bobm123/The-Open-Book/Open Book Abridged/OSO-BOOK-C2-02.brd

## EAGLE design Open Book Abridged/OSO-BOOK-C2-02.brd (2022-04-10)

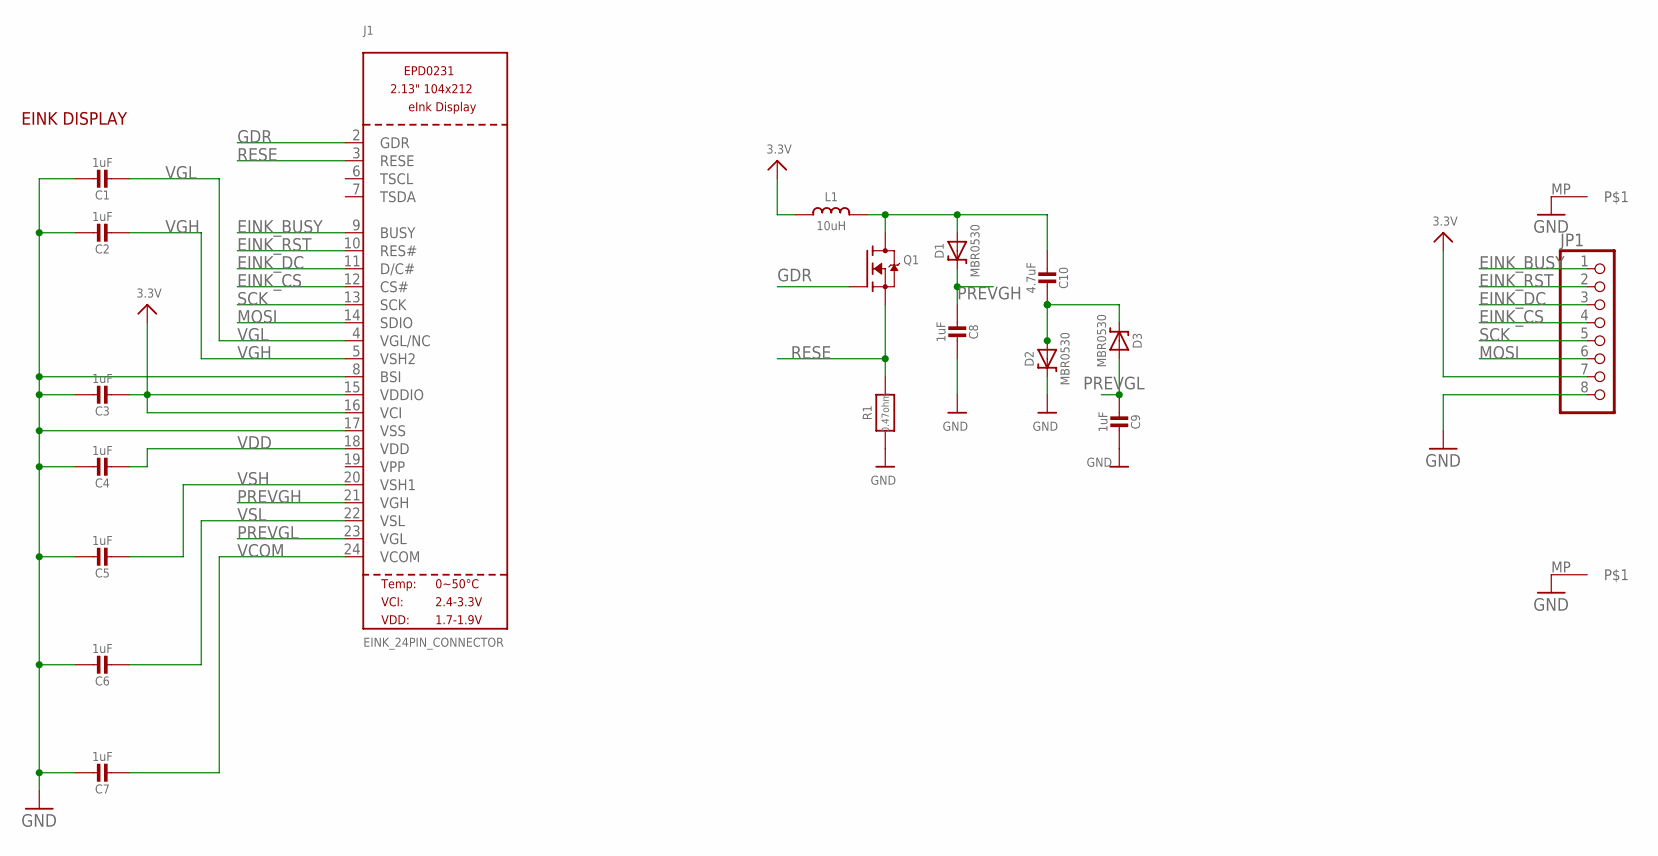
[picture p1: schematic OSO-BOOK-C2-02.sch]

Parts:
C1, C2, C3, C4, C5, C6, C7, C8, C9: 1uF; 0805-NO
C10: 4.7uF; 0805-NO
D1, D2, D3: MBR0530; SOD-123
J1: EINK_24PIN_CONNECTOR; EINK_24PIN
JP1: HEADER-1X8ROUND76; 1X08_ROUND_76
L1: 10uH; MICROBUILDER__0805
Q1: IRLML0100; SOT23-3
R1: 0.47ohm; _0402
U$2, U$3: BIGOVAL

Connections:
3.3V: C3.2, J1.15 (VDDIO), J1.16 (VCI), JP1.7, L1.1
EINK_BUSY: J1.9 (BUSY), JP1.1
EINK_CS: J1.12 (CS#), JP1.4
EINK_DC: J1.11 (D/C#), JP1.3
EINK_RST: J1.10 (RES#), JP1.2
GDR: J1.2 (GDR), Q1.1 (G)
GND: C1.1, C2.1, C3.1, C4.1, C5.1, C6.1, C7.1, C8.2, C9.2, D2.C, J1.8 (BSI), J1.17 (VSS), JP1.8, R1.2, U$2.MP, U$3.MP
MOSI: J1.14 (SDIO), JP1.6
unnamed: C10.2, D2.A, D3.C
unnamed: C10.1, D1.A, L1.2, Q1.3 (D)
PREVGH: C8.1, D1.C, J1.21 (VGH)
PREVGL: C9.1, D3.A, J1.23 (VGL)
RESE: J1.3 (RESE), Q1.2 (S), R1.1
SCK: J1.13 (SCK), JP1.5
VCOM: C7.2, J1.24 (VCOM)
VDD: C4.2, J1.18 (VDD)
VGH: C2.2, J1.5 (VSH2)
VGL: C1.2, J1.4 (VGL/NC)
VSH: C5.2, J1.20 (VSH1)
VSL: C6.2, J1.22 (VSL)

Notes on the sheet:
EINK DISPLAY

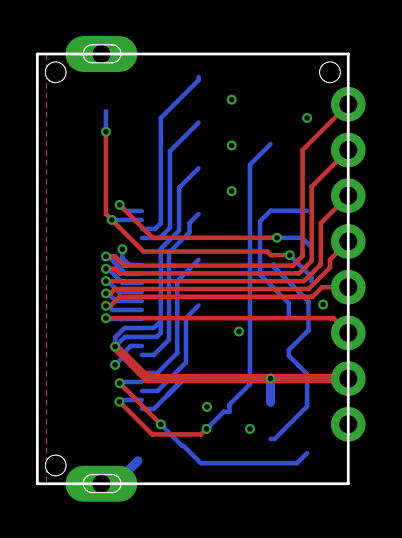
[picture p2: board OSO-BOOK-C2-02.brd from above]

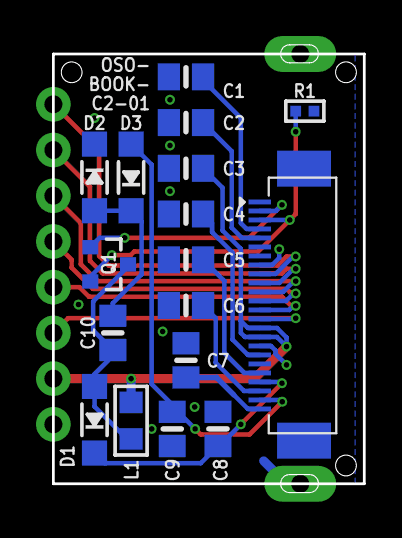
[picture p3: board OSO-BOOK-C2-02.brd from below]

Board: 2 copper layers, 17.3 x 24.9 mm, 20 parts (17 on the bottom side), 20 nets.
