bobm123/The-Open-Book/Open Book Abridged/OSO-BOOK-C3-00.brd

## EAGLE design Open Book Abridged/OSO-BOOK-C3-00.brd (2022-04-10)

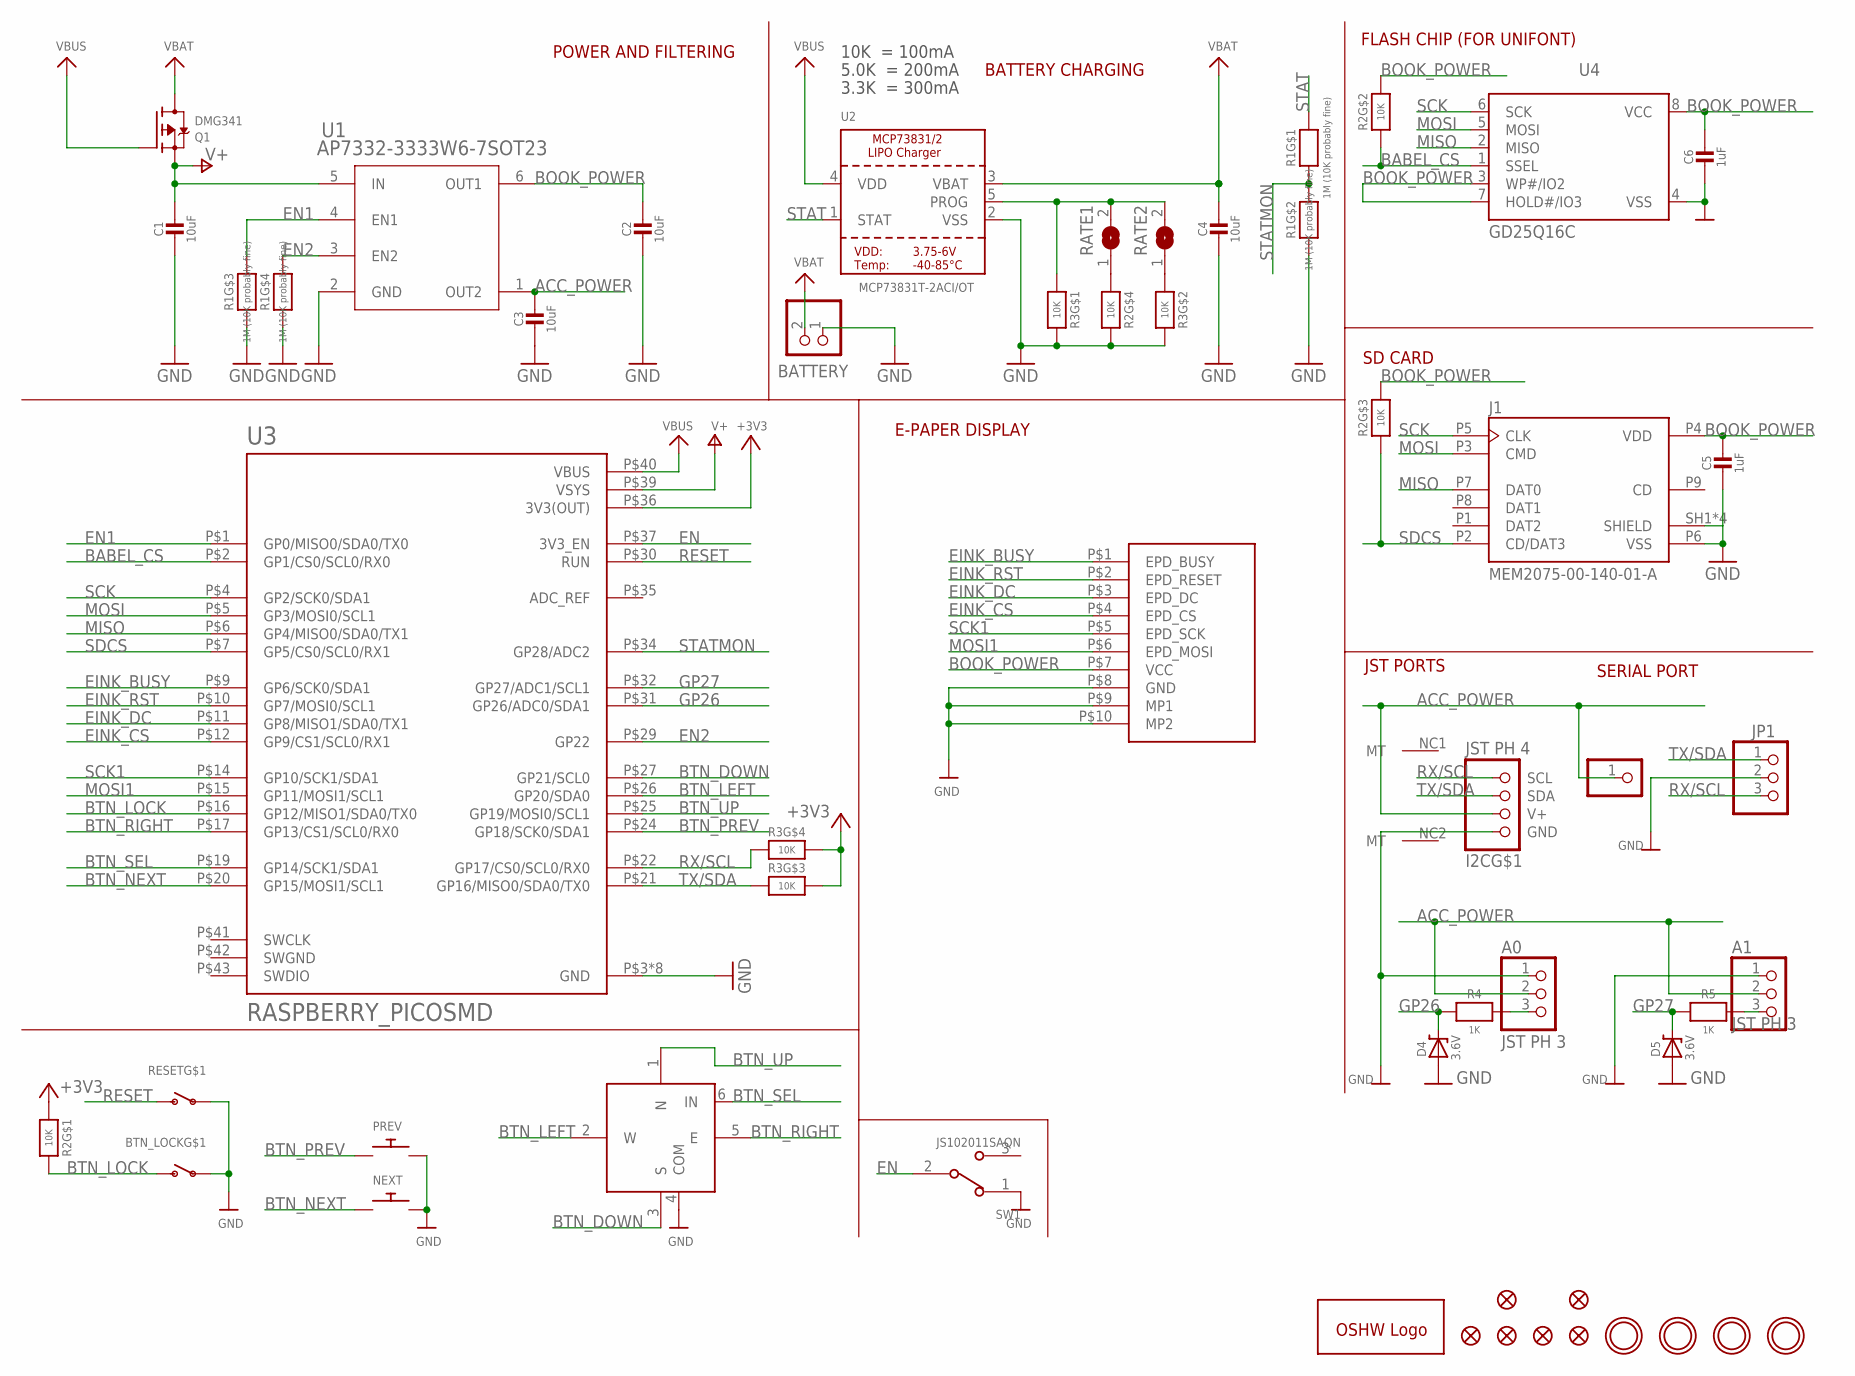
[picture p4: schematic OSO-BOOK-C3-00.sch, sheet 1]

Parts:
A0, A1: JST PH 3; JSTPH3
BATTERY: JSTPH; JSTPH2
BTN_LOCK: SWITCH_SPSTTL3330A; TL3330A
C1, C2, C3, C4: 10uF; 0805-NO
C5, C6: 1uF; 0805-NO
D4, D5: 3.6V; SOD-123
FID1, FID2, FID3, FID4, FID5, FID6: FIDUCIAL_1MM
GOLD_ORB_SM1: OSHWLOGOLOGO5MM; OSHW_5MM
I2C: JST PH 4; JSTPH4
J1: MEM2075-00-140-01-A; GCT_MEM2075-00-140-01-A
JP1: PINHD-1X3; 1X03
JP2: PINHD-1X1; 1X01
NEXT: SWITCH_PUSHBUTTON_3.5X6MM; TACTILE_3X6MM
PREV: SWITCH_PUSHBUTTON_3.5X6MM; TACTILE_3X6MM
Q1: DMG341; SOT23-R
R1: 1M (10K probably fine); EXBV8V
R2, R3: 10K; EXBV8V
R4, R5: 1K; 0805-NO
RATE1, RATE2: SOLDERJUMPER; SOLDERJUMPER_ARROW_NOPASTE
RESET: SWITCH_SPSTTL3330A; TL3330A
SW1: JS102011SAQN; SW_JS102011SAQN
SW2: NAVSWITCHSKQUABAUE010; SKQUBAE010
U1: AP7332-3333W6-7SOT23; SOT23-6
U2: MCP73831T-2ACI/OT; SOT23-5
U3: RASPBERRY_PICOSMD; PICO-PKG-SMD
U4: GD25Q16C; MICROBUILDER_SOIC8_150MIL
U$1, U$4, U$5, U$7: MOUNTINGHOLE2.5; MOUNTINGHOLE_2.5_PLATED
U$11: OSO-BOOK-C2-01

Connections:
+3V3: R2.1, R3.5 (2), R3.6 (2), U3.P$36 (3V3(OUT))
ACC_POWER: A0.2, A1.2, C3.1, I2C.2 (V+), JP2.1, U1.1 (OUT2)
BABEL_CS: R2.2 (1), U3.P$2 (GP1/CS0/SCL0/RX0), U4.1 (SSEL)
BOOK_POWER: C2.1, C5.1, C6.1, J1.P4 (VDD), R2.6 (2), R2.7 (2), U1.6 (OUT1), U4.3 (WP#/IO2), U4.7 (HOLD#/IO3), U4.8 (VCC), U$11.P$7 (VCC)
BTN_DOWN: SW2.3 (S), U3.P$27 (GP21/SCL0)
BTN_LEFT: SW2.2 (W), U3.P$26 (GP20/SDA0)
BTN_LOCK: BTN_LOCK.P$2 (S), R2.8 (2), U3.P$16 (GP12/MISO1/SDA0/TX0)
BTN_NEXT: NEXT.P$1, U3.P$20 (GP15/MOSI1/SCL1)
BTN_PREV: PREV.P$1, U3.P$24 (GP18/SCK0/SDA1)
BTN_RIGHT: SW2.5 (E), U3.P$17 (GP13/CS1/SCL0/RX0)
BTN_SEL: SW2.6 (IN), U3.P$19 (GP14/SCK1/SDA1)
BTN_UP: SW2.1 (N), U3.P$25 (GP19/MOSI0/SCL1)
EINK_BUSY: U3.P$9 (GP6/SCK0/SDA1), U$11.P$1 (EPD_BUSY)
EINK_CS: U3.P$12 (GP9/CS1/SCL0/RX1), U$11.P$4 (EPD_CS)
EINK_DC: U3.P$11 (GP8/MISO1/SDA0/TX1), U$11.P$3 (EPD_DC)
EINK_RST: U3.P$10 (GP7/MOSI0/SCL1), U$11.P$2 (EPD_RESET)
EN: SW1.2, U3.P$37 (3V3_EN)
EN1: R1.3 (1), U1.4 (EN1), U3.P$1 (GP0/MISO0/SDA0/TX0)
EN2: R1.4 (1), U1.3 (EN2), U3.P$29 (GP22)
GND: A0.1, A1.1, BATTERY.1, BTN_LOCK.P$1, C1.2, C2.2, C3.2, C4.2, C5.2, C6.2, D4.A, D5.A, I2C.1 (GND), J1.P6 (VSS), J1.SH1 (SHIELD), J1.SH2 (SHIELD), J1.SH3 (SHIELD), J1.SH4 (SHIELD), JP1.2, NEXT.P$2, PREV.P$2, R1.2 (1), R1.5 (2), R1.6 (2), R2.5 (2), R3.7 (2), R3.8 (2), RESET.P$1, SW1.1, SW2.4 (COM), U1.2 (GND), U2.2 (VSS), U3.P$3 (GND), U3.P$8 (GND), U3.P$13 (GND), U3.P$18 (GND), U3.P$23 (GND), U3.P$28 (GND), U3.P$33 (GND), U3.P$38 (GND), U4.4 (VSS), U$11.P$8 (GND), U$11.P$9 (MP1), U$11.P$10 (MP2)
GP26: D4.C, R4.2, U3.P$31 (GP26/ADC0/SDA1)
GP27: D5.C, R5.2, U3.P$32 (GP27/ADC1/SCL1)
MISO: J1.P7 (DAT0), U3.P$6 (GP4/MISO0/SDA0/TX1), U4.2 (MISO)
MOSI: J1.P3 (CMD), U3.P$5 (GP3/MOSI0/SCL1), U4.5 (MOSI)
MOSI1: U3.P$15 (GP11/MOSI1/SCL1), U$11.P$6 (EPD_MOSI)
unnamed: R2.4 (1), RATE1.1
unnamed: R3.2 (1), RATE2.1
PROG: R3.1, RATE1.2, RATE2.2, U2.5 (PROG)
RESET: RESET.P$2 (S), U3.P$30 (RUN)
RX/SCL: I2C.4 (SCL), JP1.3, R3.4 (1), U3.P$22 (GP17/CS0/SCL0/RX0)
SCK: J1.P5 (CLK), U3.P$4 (GP2/SCK0/SDA1), U4.6 (SCK)
SCK1: U3.P$14 (GP10/SCK1/SDA1), U$11.P$5 (EPD_SCK)
SDCS: J1.P2 (CD/DAT3), R2.3 (1), U3.P$7 (GP5/CS0/SCL0/RX1)
STAT: R1.8 (2), U2.1 (STAT)
STATMON: R1.1, R1.7 (2), U3.P$34 (GP28/ADC2)
SWGND: U3.P$42 (SWGND)
TX/SDA: I2C.3 (SDA), JP1.1, R3.3 (1), U3.P$21 (GP16/MISO0/SDA0/TX0)
V+: C1.1, Q1.2 (S), U1.5 (IN), U3.P$39 (VSYS)
VBAT: BATTERY.2, C4.1, Q1.3 (D), U2.3 (VBAT)
VBUS: Q1.1 (G), U2.4 (VDD), U3.P$40 (VBUS)
_GP26: A0.3, R4.1
_GP27: A1.3, R5.1

Notes on the sheet:
POWER AND FILTERING
10K = 100mA
5.0K = 200mA
3.3K = 300mA
BATTERY CHARGING
FLASH CHIP (FOR UNIFONT)
SERIAL PORT
JST PORTS
SD CARD
E-PAPER DISPLAY

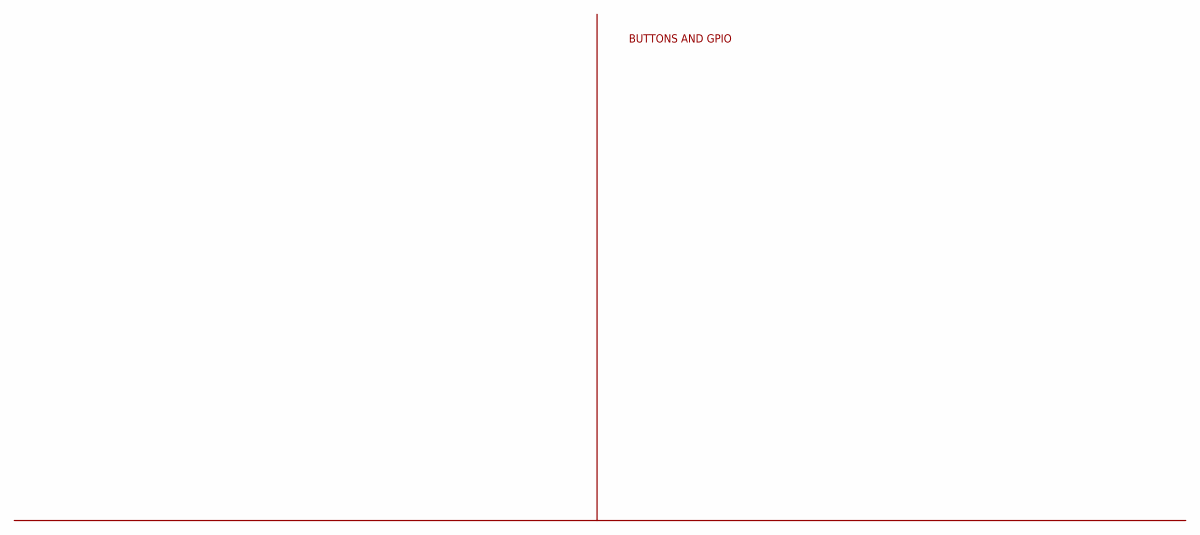
[picture p5: schematic OSO-BOOK-C3-00.sch, sheet 2]

Notes on the sheet:
BUTTONS AND GPIO

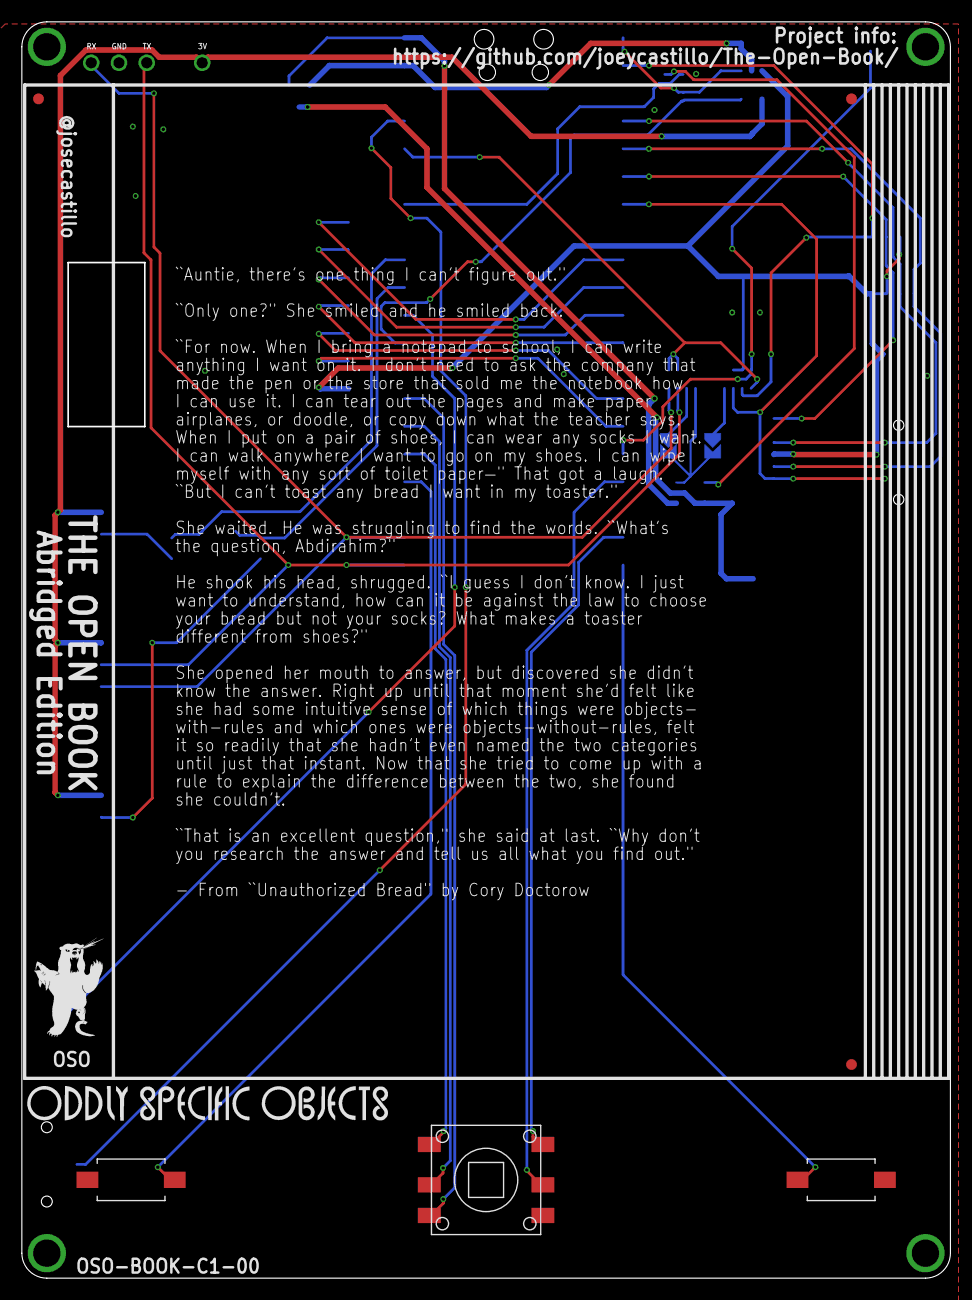
[picture p6: board OSO-BOOK-C3-00.brd from above]

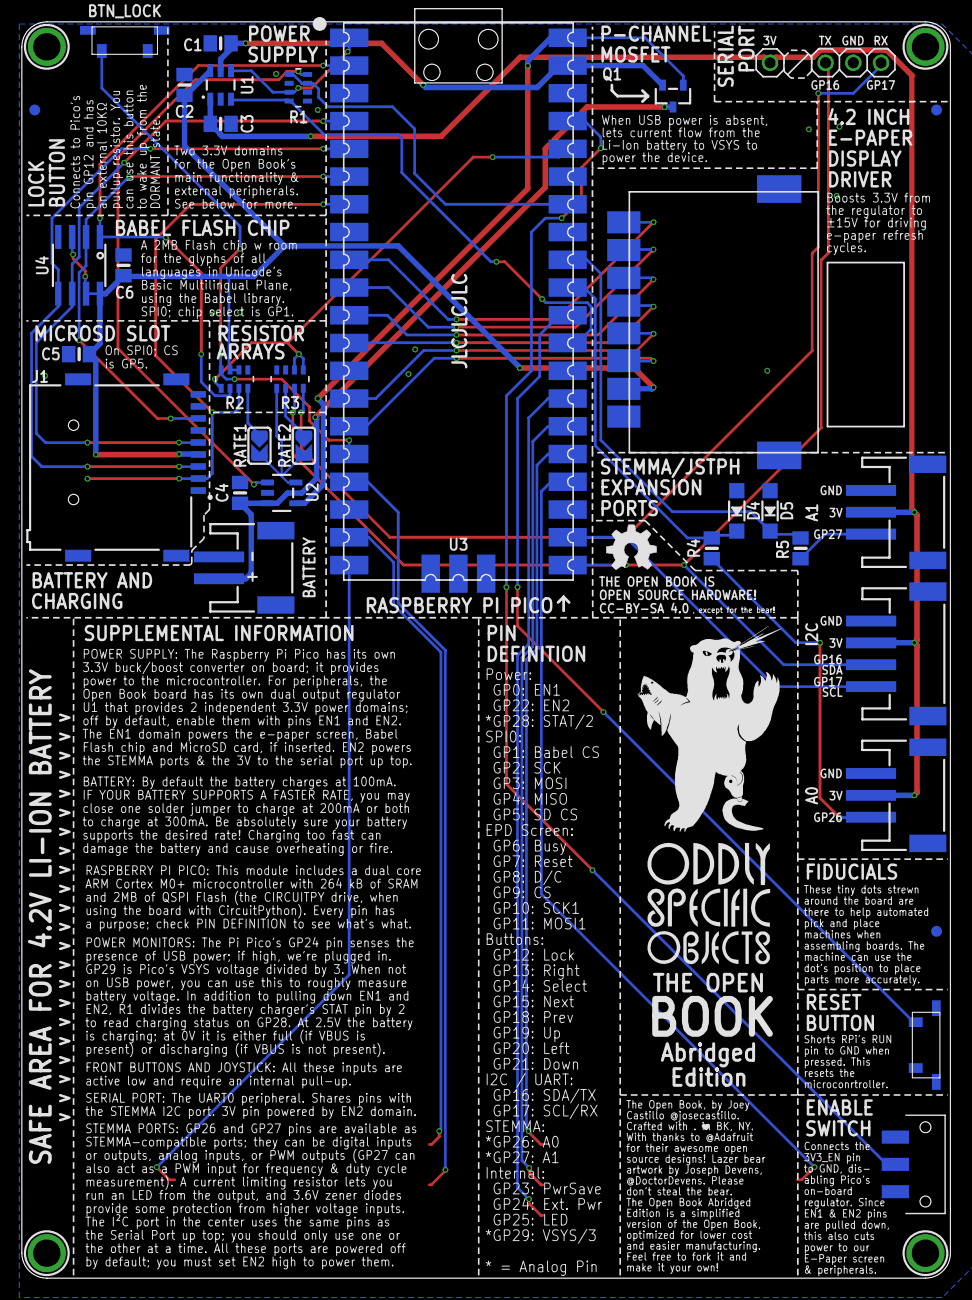
[picture p7: board OSO-BOOK-C3-00.brd from below]

Board: 2 copper layers, 85.0 x 115.0 mm, 49 parts (41 on the bottom side), 41 nets.

Other parts of the board:
U$45: OSO_WORDMARK_125X1300MIL_1000DPI
U$47: OSO_BEAR_525X750MIL_1000DPI
U$49: OSO_WORDMARK_THREELINE_450MIL_1000DPI
U$65: OSO_BEAR_250X360MIL_1000DPI
