bobm123/The-Open-Book/(commit log)

2022-04-10 Copy the OSO-BOOK-C1-01 main board, hope to use an OTS module for battery management
    [OSO-BOOK-C3-00.brd, OSO-BOOK-C3-00.sch]
2022-04-10 Adds a copy of -C2 (display breakout) with some hidden text removed
    [OSO-BOOK-C2-02.brd, OSO-BOOK-C2-02.sch]
