bobm123/The-Open-Book/(notices)

Notices in the files:
Open Book Abridged/OSO-BOOK-C3-00.brd:
CC-BY-SA 4.0
